arhefner/1802-Mini-SPI-DMA/README.md

# 1802-Mini-SPI-DMA
SPI Expansion Board for the 1802/Mini Computer
