arhefner/1802-Mini-SPI-DMA/1802-Mini-SPI-DMA.kicad_pcb

## KiCad design 1802-Mini-SPI-DMA.kicad_pcb (2022-12-16)

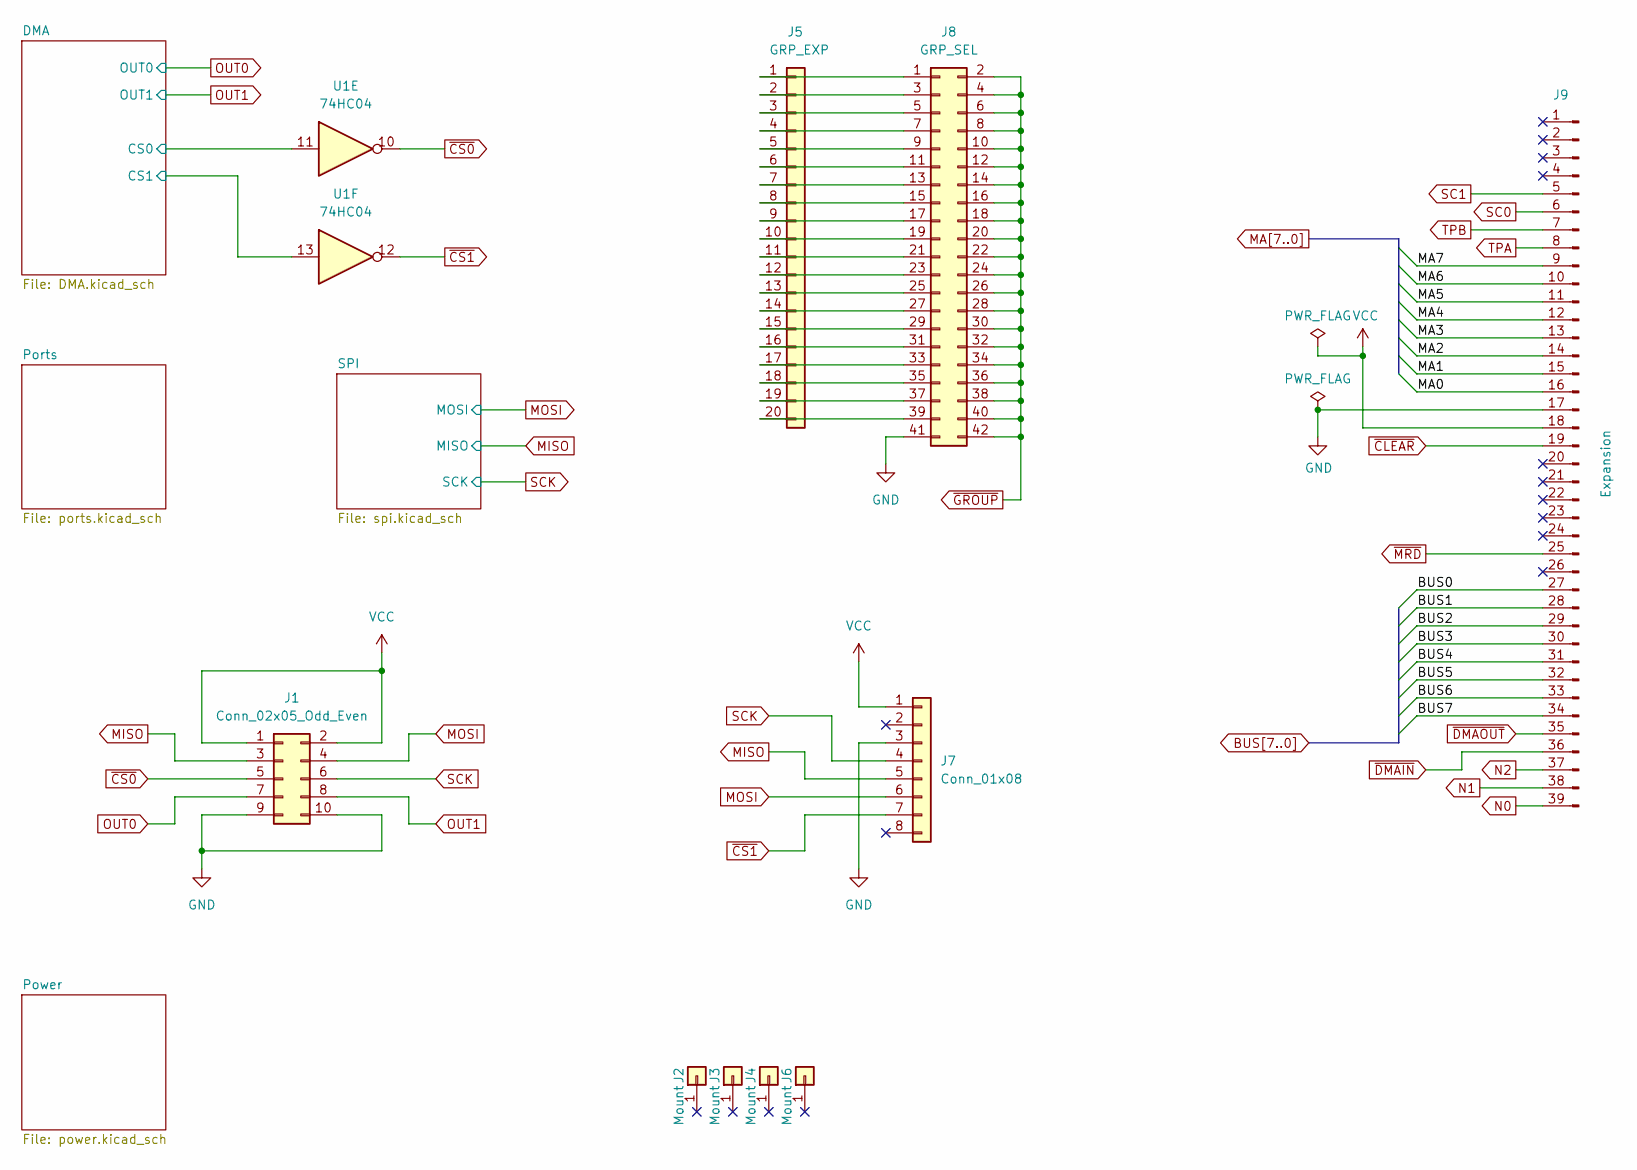
[picture p1: schematic 1802-Mini-SPI-DMA.kicad_sch]

Parts:
J1: Conn_02x05_Odd_Even; PinHeader_2x05_P2.54mm_Horizontal
J2, J3, J4, J6: Mount; 1pin
J5: GRP_EXP; PinHeader_1x20_P2.54mm_Vertical
J7: Conn_01x08; Adafruit_micro_sd_adapter
J8: GRP_SEL; PinHeader_2x21_P2.54mm_Vertical
J9: Expansion; Pin_Header_Straight_1x39_Pitch2.54mm
U1: 74HC04; DIP-14_W7.62mm_Socket

Connections:
/DMA/CS0: U1.11; also elsewhere on the board
/DMA/CS1: U1.13; also elsewhere on the board
BUS0: J9.27; also elsewhere on the board
BUS1: J9.28; also elsewhere on the board
BUS2: J9.29; also elsewhere on the board
BUS3: J9.30; also elsewhere on the board
BUS4: J9.31; also elsewhere on the board
BUS5: J9.32; also elsewhere on the board
BUS6: J9.33; also elsewhere on the board
BUS7: J9.34; also elsewhere on the board
GND: J1.9, J1.10, J7.3, J8.41, J9.17; also elsewhere on the board
MA0: J9.16
MA1: J9.15
MA2: J9.14
MA3: J9.13
MA4: J9.12
MA5: J9.11
MA6: J9.10
MA7: J9.9
MISO: J1.3, J7.5; also elsewhere on the board
MOSI: J1.4, J7.6; also elsewhere on the board
N0: J9.39; also elsewhere on the board
N1: J9.38; also elsewhere on the board
N2: J9.37; also elsewhere on the board
unnamed: J5.1, J8.1
unnamed: J5.2, J8.3
unnamed: J5.3, J8.5
unnamed: J5.4, J8.7
unnamed: J5.5, J8.9
unnamed: J5.6, J8.11
unnamed: J5.7, J8.13
unnamed: J5.8, J8.15
unnamed: J5.9, J8.17
unnamed: J5.10, J8.19
unnamed: J5.11, J8.21
unnamed: J5.12, J8.23
unnamed: J5.13, J8.25
unnamed: J5.14, J8.27
unnamed: J5.15, J8.29
unnamed: J5.16, J8.31
unnamed: J5.17, J8.33
unnamed: J5.18, J8.35
unnamed: J5.19, J8.37
unnamed: J5.20, J8.39
OUT0: J1.7; also elsewhere on the board
OUT1: J1.8; also elsewhere on the board
SC0: J9.6; also elsewhere on the board
SC1: J9.5; also elsewhere on the board
SCK: J1.6, J7.4; also elsewhere on the board
TPA: J9.8; also elsewhere on the board
TPB: J9.7; also elsewhere on the board
VCC: J1.1, J1.2, J7.1, J9.18; also elsewhere on the board
~CLEAR: J9.19; also elsewhere on the board
~CS0: J1.5, U1.10
~CS1: J7.7, U1.12
~DMAIN: J9.36; also elsewhere on the board
~DMAOUT: J9.35; also elsewhere on the board
~GROUP: J8.2, J8.4, J8.6, J8.8, J8.10, J8.12, J8.14, J8.16, J8.18, J8.20, J8.22, J8.24, J8.26, J8.28, J8.30, J8.32, J8.34, J8.36, J8.38, J8.40, J8.42; also elsewhere on the board
~MRD: J9.25; also elsewhere on the board

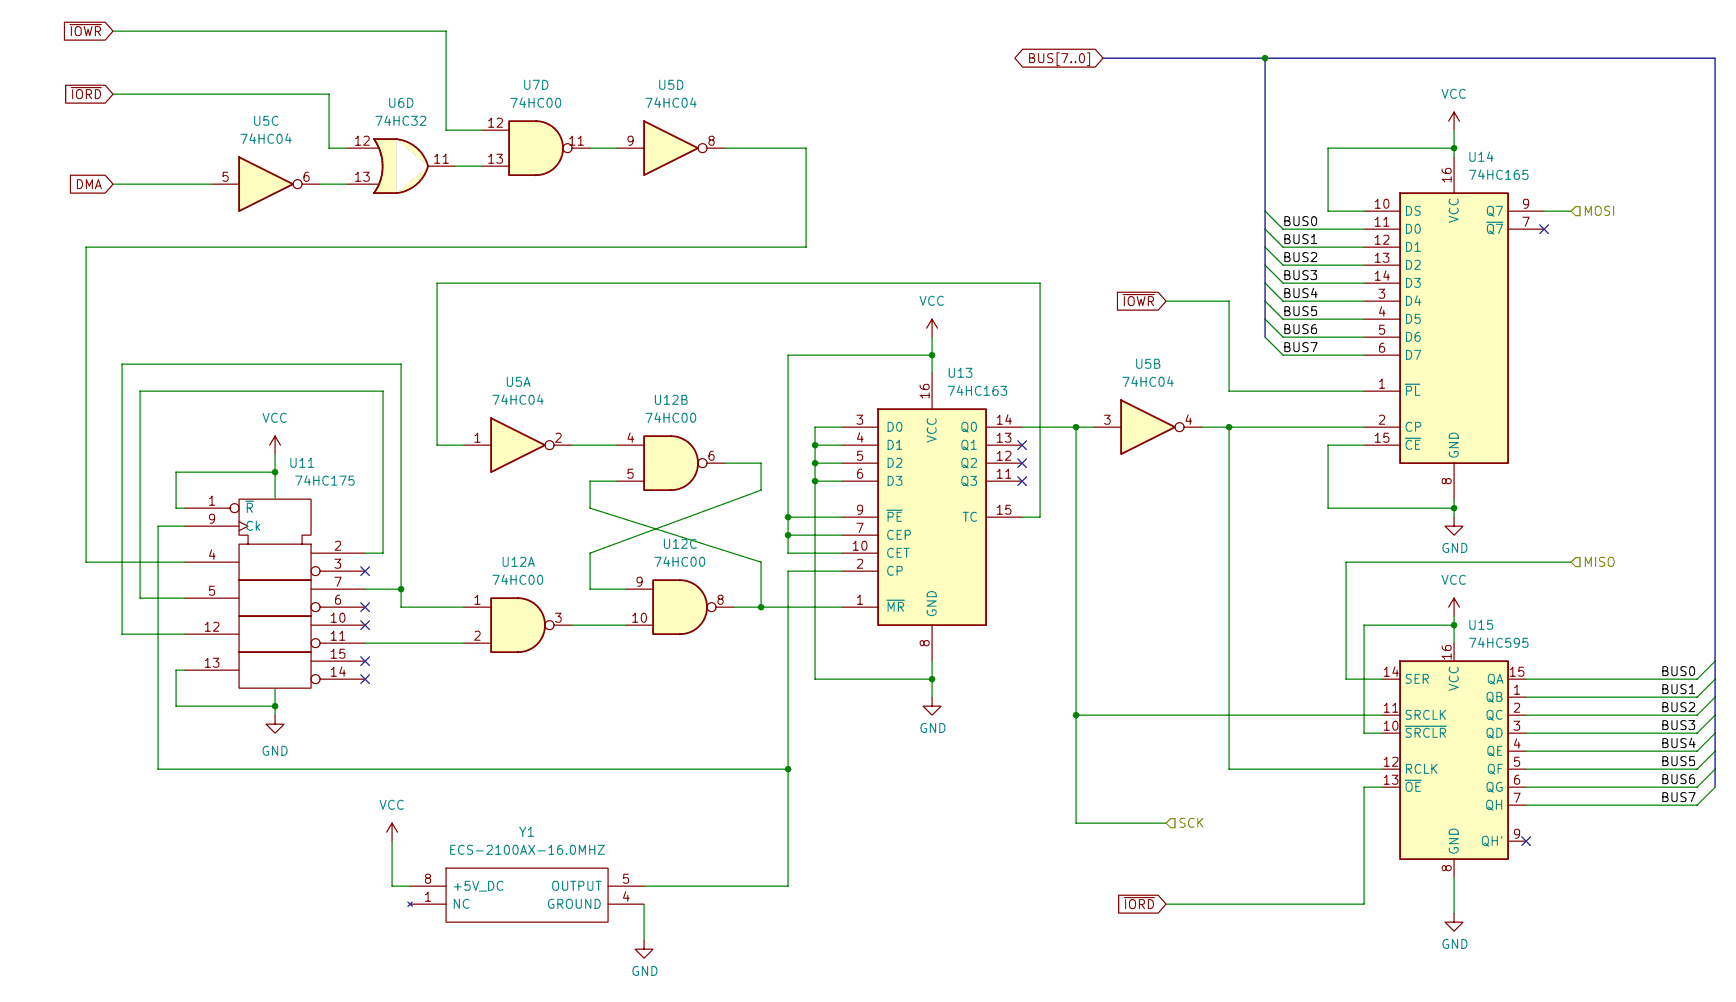
[picture p2: schematic spi.kicad_sch]

Parts:
U5: 74HC04; DIP-14_W7.62mm_Socket
U6: 74HC32; DIP-14_W7.62mm_Socket
U7, U12: 74HC00; DIP-14_W7.62mm_Socket
U11: 74HC175; DIP-16_W7.62mm_Socket
U13: 74HC163; DIP-16_W7.62mm_Socket
U14: 74HC165; DIP-16_W7.62mm_Socket
U15: 74HC595; DIP-16_W7.62mm_Socket
Y1: ECS-2100AX-16.0MHZ; ECS2100AX160MHZ; Mouser Part Number 520-TCH1600-X

Connections:
BUS0: U14.11 (D0), U15.15 (QA); also elsewhere on the board
BUS1: U14.12 (D1), U15.1 (QB); also elsewhere on the board
BUS2: U14.13 (D2), U15.2 (QC); also elsewhere on the board
BUS3: U14.14 (D3), U15.3 (QD); also elsewhere on the board
BUS4: U14.3 (D4), U15.4 (QE); also elsewhere on the board
BUS5: U14.4 (D5), U15.5 (QF); also elsewhere on the board
BUS6: U14.5 (D6), U15.6 (QG); also elsewhere on the board
BUS7: U14.6 (D7), U15.7 (QH); also elsewhere on the board
DMA: U5.5; also elsewhere on the board
GND: U11.8 (Vss), U11.13, U13.3 (D0), U13.4 (D1), U13.5 (D2), U13.6 (D3), U13.8 (GND), U14.8 (GND), U14.15 (~CE), U15.8 (GND), Y1.4 (GROUND); also elsewhere on the board
MISO: U15.14 (SER); also elsewhere on the board
MOSI: U14.9 (Q7); also elsewhere on the board
unnamed: U5.6, U6.13
unnamed: U5.9, U7.11
unnamed: U6.11, U7.13
unnamed: U11.2, U11.5
unnamed: U5.8, U11.4
unnamed: U11.9 (Ck), U13.2 (CP), Y1.5 (OUTPUT)
unnamed: U11.11, U12.2
unnamed: U11.7, U11.12, U12.1
unnamed: U5.2, U12.4
unnamed: U12.5, U12.8, U13.1 (~MR)
unnamed: U12.6, U12.9
unnamed: U12.3, U12.10
unnamed: U5.1, U13.15 (TC)
unnamed: U5.4, U14.2 (CP), U15.12 (RCLK)
SCK: U5.3, U13.14 (Q0), U15.11 (SRCLK); also elsewhere on the board
VCC: U11.1 (~R), U11.16 (Vdd), U13.7 (CEP), U13.9 (~PE), U13.10 (CET), U13.16 (VCC), U14.10 (DS), U14.16 (VCC), U15.10 (~SRCLR), U15.16 (VCC), Y1.8 (+5V_DC); also elsewhere on the board
~IORD: U6.12, U15.13 (~OE); also elsewhere on the board
~IOWR: U7.12, U14.1 (~PL); also elsewhere on the board

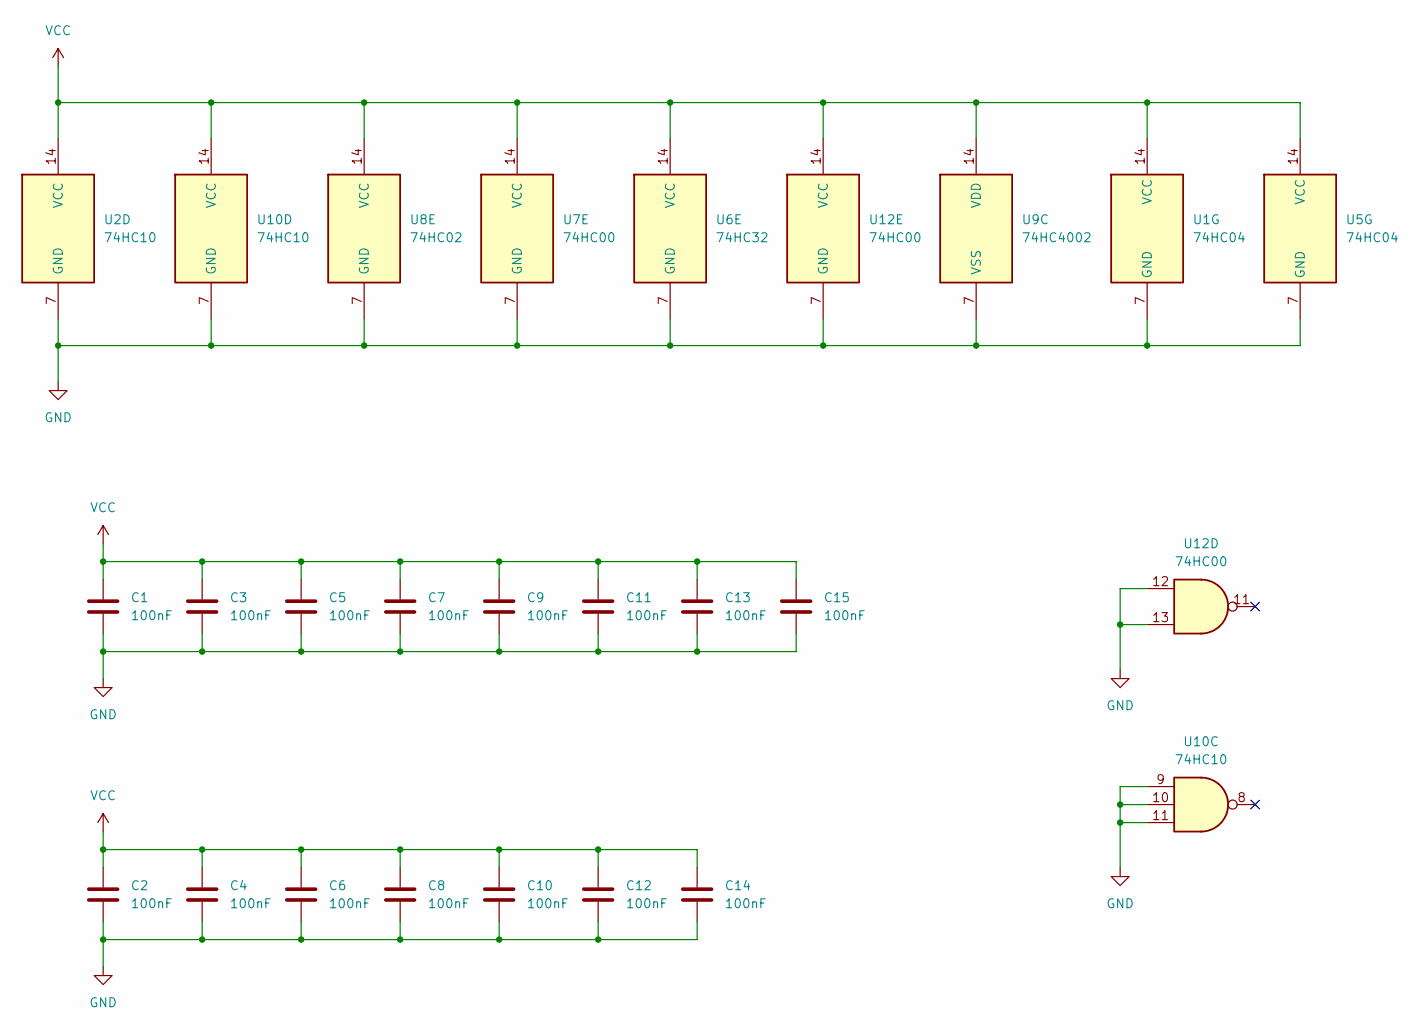
[picture p3: schematic power.kicad_sch]

Parts:
C1, C2, C3, C4, C5, C6, C7, C8, C9, C10, C11, C12, C13, C14, C15: 100nF; C_Disc_D4.7mm_W2.5mm_P5.00mm
U1, U5: 74HC04; DIP-14_W7.62mm_Socket
U2, U10: 74HC10; DIP-14_W7.62mm_Socket
U6: 74HC32; DIP-14_W7.62mm_Socket
U7, U12: 74HC00; DIP-14_W7.62mm_Socket
U8: 74HC02; DIP-14_W7.62mm_Socket
U9: 74HC4002; DIP-14_W7.62mm_Socket

Connections:
GND: C1.1, C2.1, C3.1, C4.1, C5.1, C6.1, C7.1, C8.1, C9.1, C10.1, C11.1, C12.1, C13.1, C14.1, C15.1, U1.7 (GND), U2.7 (GND), U5.7 (GND), U6.7 (GND), U7.7 (GND), U8.7 (GND), U9.7 (VSS), U10.7 (GND), U10.9, U10.10, U10.11, U12.7 (GND), U12.12, U12.13; also elsewhere on the board
VCC: C1.2, C2.2, C3.2, C4.2, C5.2, C6.2, C7.2, C8.2, C9.2, C10.2, C11.2, C12.2, C13.2, C14.2, C15.2, U1.14 (VCC), U2.14 (VCC), U5.14 (VCC), U6.14 (VCC), U7.14 (VCC), U8.14 (VCC), U9.14 (VDD), U10.14 (VCC), U12.14 (VCC); also elsewhere on the board

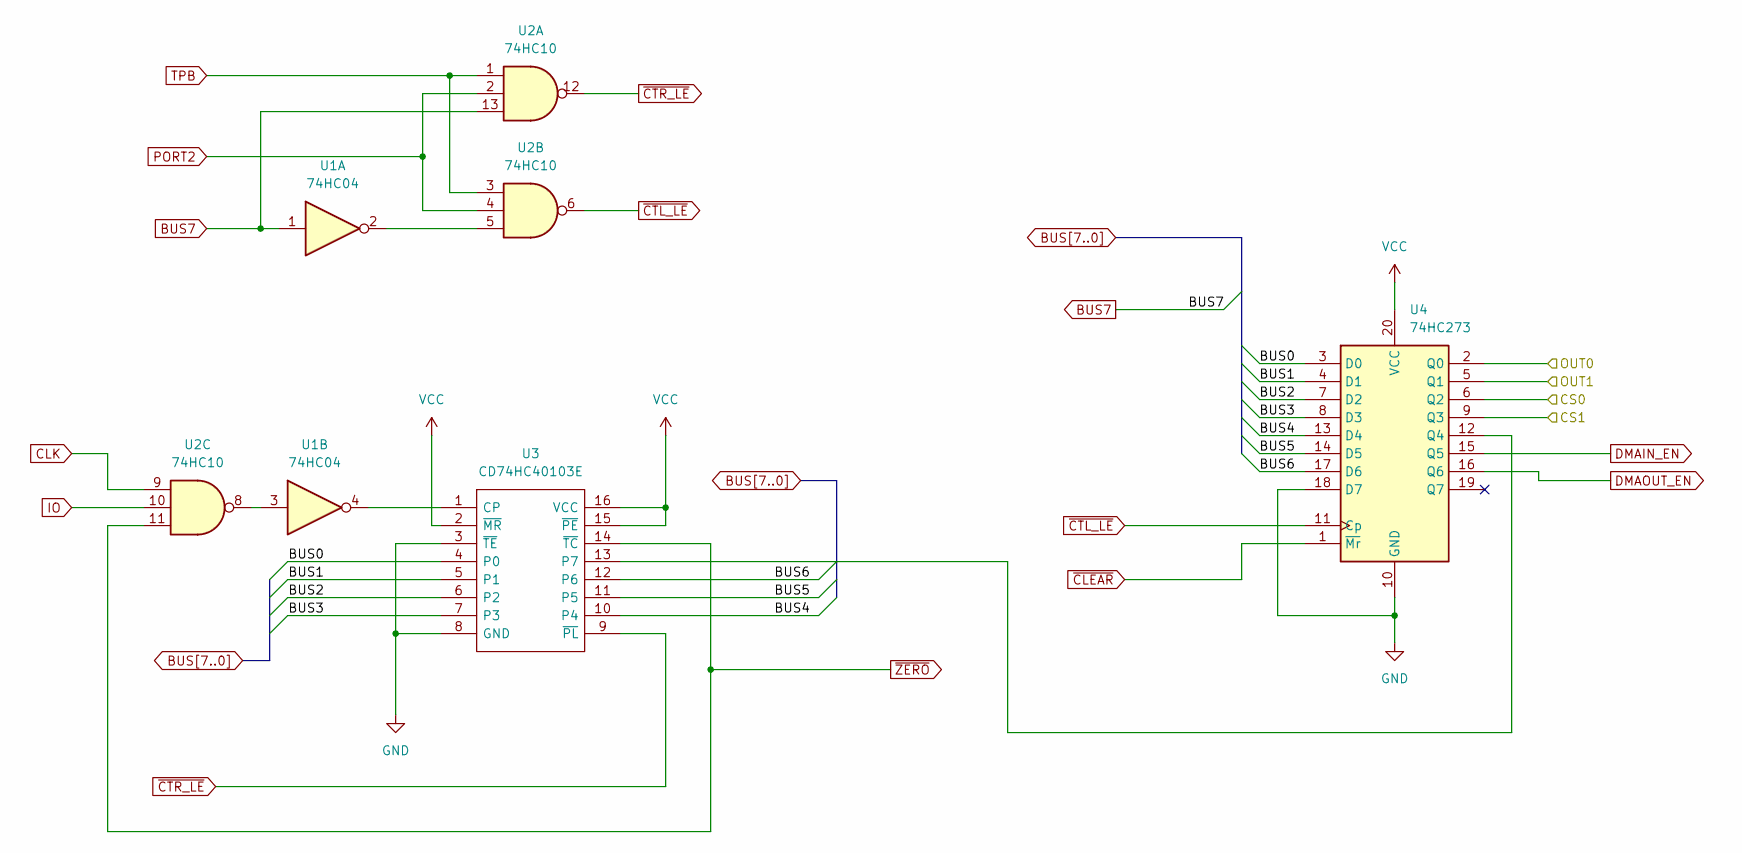
[picture p4: schematic DMA.kicad_sch]

Parts:
U1: 74HC04; DIP-14_W7.62mm_Socket
U2: 74HC10; DIP-14_W7.62mm_Socket
U3: CD74HC40103E; DIP-16_W7.62mm_Socket; Mouser Part Number 595-CD74HC40103E
U4: 74HC273; DIP-20_W7.62mm_Socket

Connections:
/DMA/CS0: U4.6 (Q2); also elsewhere on the board
/DMA/CS1: U4.9 (Q3); also elsewhere on the board
BUS0: U3.4 (P0), U4.3 (D0); also elsewhere on the board
BUS1: U3.5 (P1), U4.4 (D1); also elsewhere on the board
BUS2: U3.6 (P2), U4.7 (D2); also elsewhere on the board
BUS3: U3.7 (P3), U4.8 (D3); also elsewhere on the board
BUS4: U3.10 (P4), U4.13 (D4); also elsewhere on the board
BUS5: U3.11 (P5), U4.14 (D5); also elsewhere on the board
BUS6: U3.12 (P6), U4.17 (D6); also elsewhere on the board
BUS7: U1.1, U2.13; also elsewhere on the board
CLK: U2.9; also elsewhere on the board
DMAIN_EN: U4.15 (Q5); also elsewhere on the board
DMAOUT_EN: U4.16 (Q6); also elsewhere on the board
GND: U3.3 (~TE), U3.8 (GND), U4.10 (GND), U4.18 (D7); also elsewhere on the board
IO: U2.10; also elsewhere on the board
unnamed: U1.2, U2.5
unnamed: U1.3, U2.8
unnamed: U1.4, U3.1 (CP)
unnamed: U3.13 (P7), U4.12 (Q4)
OUT0: U4.2 (Q0); also elsewhere on the board
OUT1: U4.5 (Q1); also elsewhere on the board
PORT2: U2.2, U2.4; also elsewhere on the board
TPB: U2.1, U2.3; also elsewhere on the board
VCC: U3.2 (~MR), U3.15 (~PE), U3.16 (VCC), U4.20 (VCC); also elsewhere on the board
~CLEAR: U4.1 (~Mr); also elsewhere on the board
~CTL_LE: U2.6, U4.11 (Cp)
~CTR_LE: U2.12, U3.9 (~PL)
~ZERO: U2.11, U3.14 (~TC); also elsewhere on the board

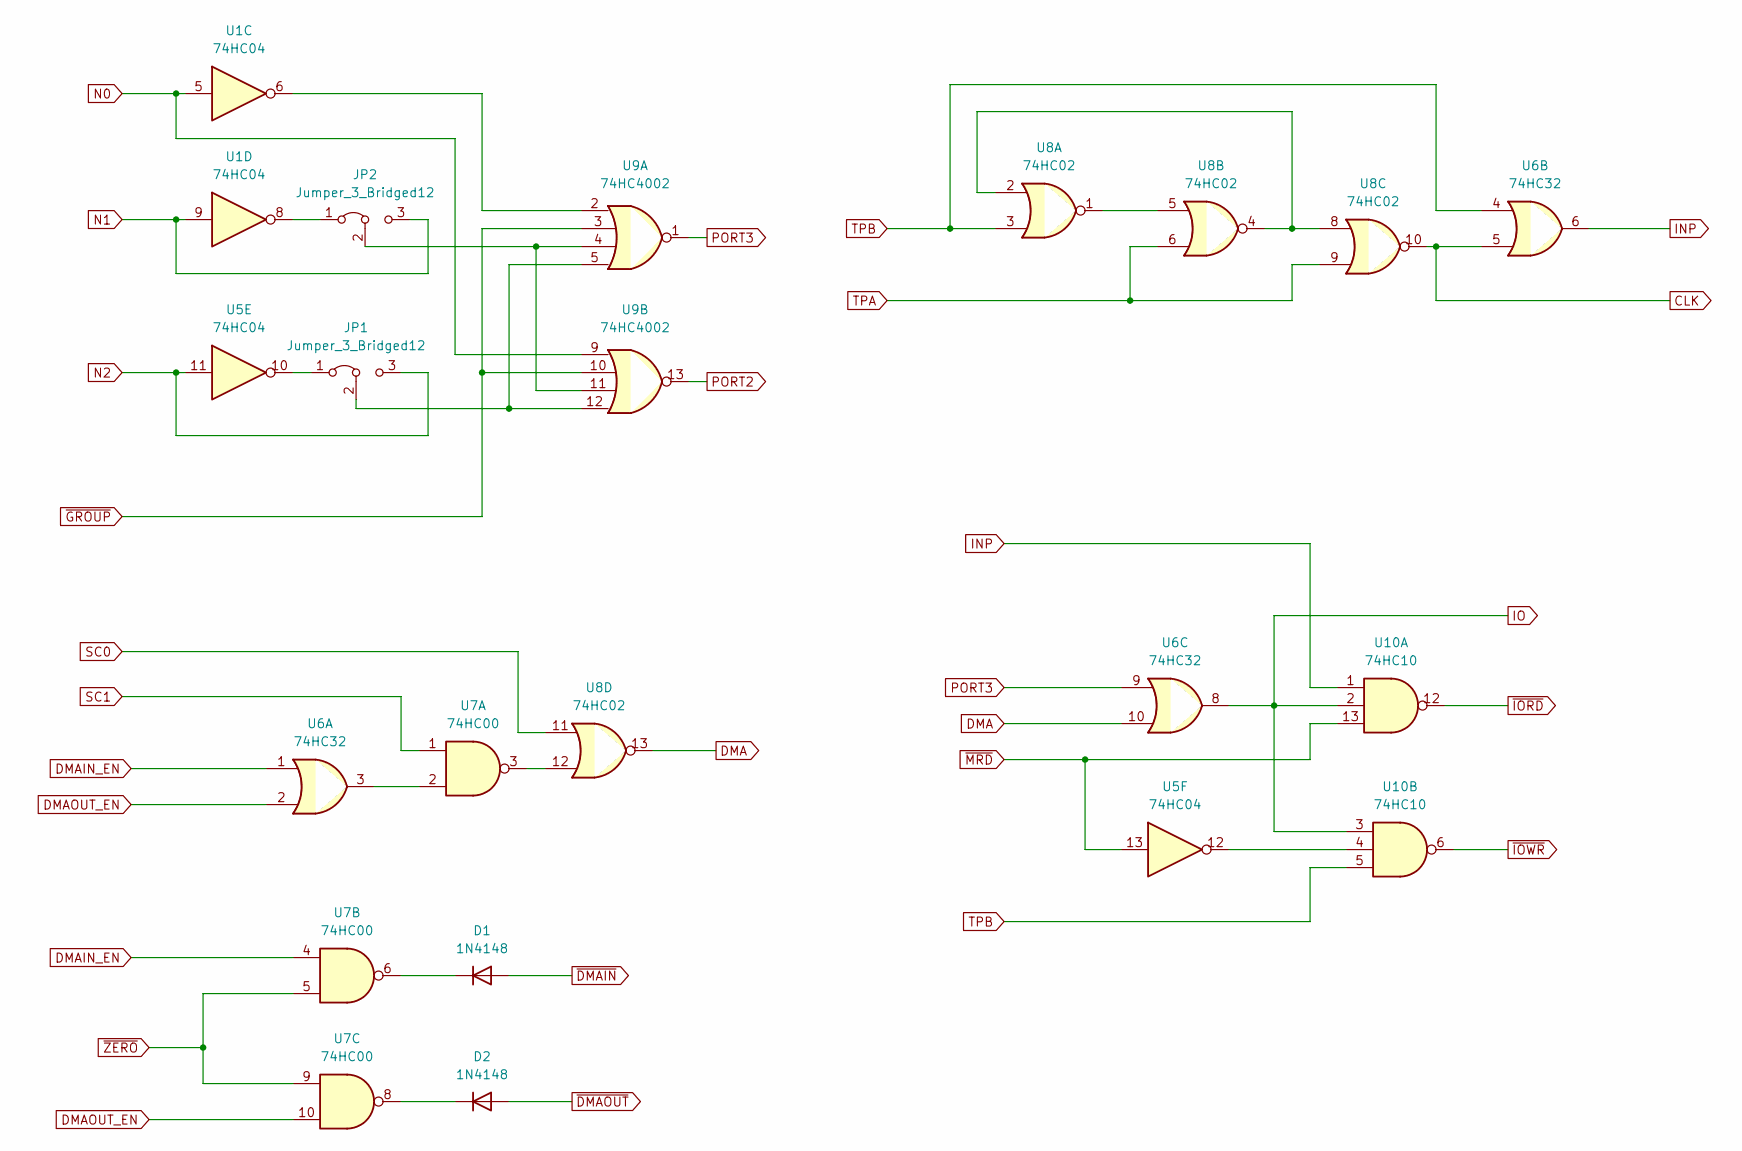
[picture p5: schematic ports.kicad_sch]

Parts:
D1, D2: 1N4148; D_DO-35_SOD27_P7.62mm_Horizontal
JP1, JP2: Jumper_3_Bridged12; PinHeader_1x03_P2.54mm_Vertical
U1, U5: 74HC04; DIP-14_W7.62mm_Socket
U6: 74HC32; DIP-14_W7.62mm_Socket
U7: 74HC00; DIP-14_W7.62mm_Socket
U8: 74HC02; DIP-14_W7.62mm_Socket
U9: 74HC4002; DIP-14_W7.62mm_Socket
U10: 74HC10; DIP-14_W7.62mm_Socket

Connections:
CLK: U6.5, U8.10; also elsewhere on the board
DMA: U6.10, U8.13; also elsewhere on the board
DMAIN_EN: U6.1, U7.4; also elsewhere on the board
DMAOUT_EN: U6.2, U7.10; also elsewhere on the board
INP: U6.6, U10.1
IO: U6.8, U10.2, U10.3; also elsewhere on the board
N0: U1.5, U9.9; also elsewhere on the board
N1: JP2.3 (B), U1.9; also elsewhere on the board
N2: JP1.3 (B), U5.11; also elsewhere on the board
unnamed: D1.1 (K), U7.6
unnamed: D2.1 (K), U7.8
unnamed: JP1.1 (A), U5.10
unnamed: JP1.2 (C), U9.5, U9.12
unnamed: JP2.1 (A), U1.8
unnamed: JP2.2 (C), U9.4, U9.11
unnamed: U1.6, U9.2
unnamed: U6.3, U7.2
unnamed: U7.3, U8.12
unnamed: U8.1, U8.5
unnamed: U8.2, U8.4, U8.8
unnamed: U5.12, U10.4
PORT2: U9.13; also elsewhere on the board
PORT3: U6.9, U9.1
SC0: U8.11; also elsewhere on the board
SC1: U7.1; also elsewhere on the board
TPA: U8.6, U8.9; also elsewhere on the board
TPB: U6.4, U8.3, U10.5; also elsewhere on the board
~DMAIN: D1.2 (A); also elsewhere on the board
~DMAOUT: D2.2 (A); also elsewhere on the board
~GROUP: U9.3, U9.10; also elsewhere on the board
~IORD: U10.12; also elsewhere on the board
~IOWR: U10.6; also elsewhere on the board
~MRD: U5.13, U10.13; also elsewhere on the board
~ZERO: U7.5, U7.9; also elsewhere on the board

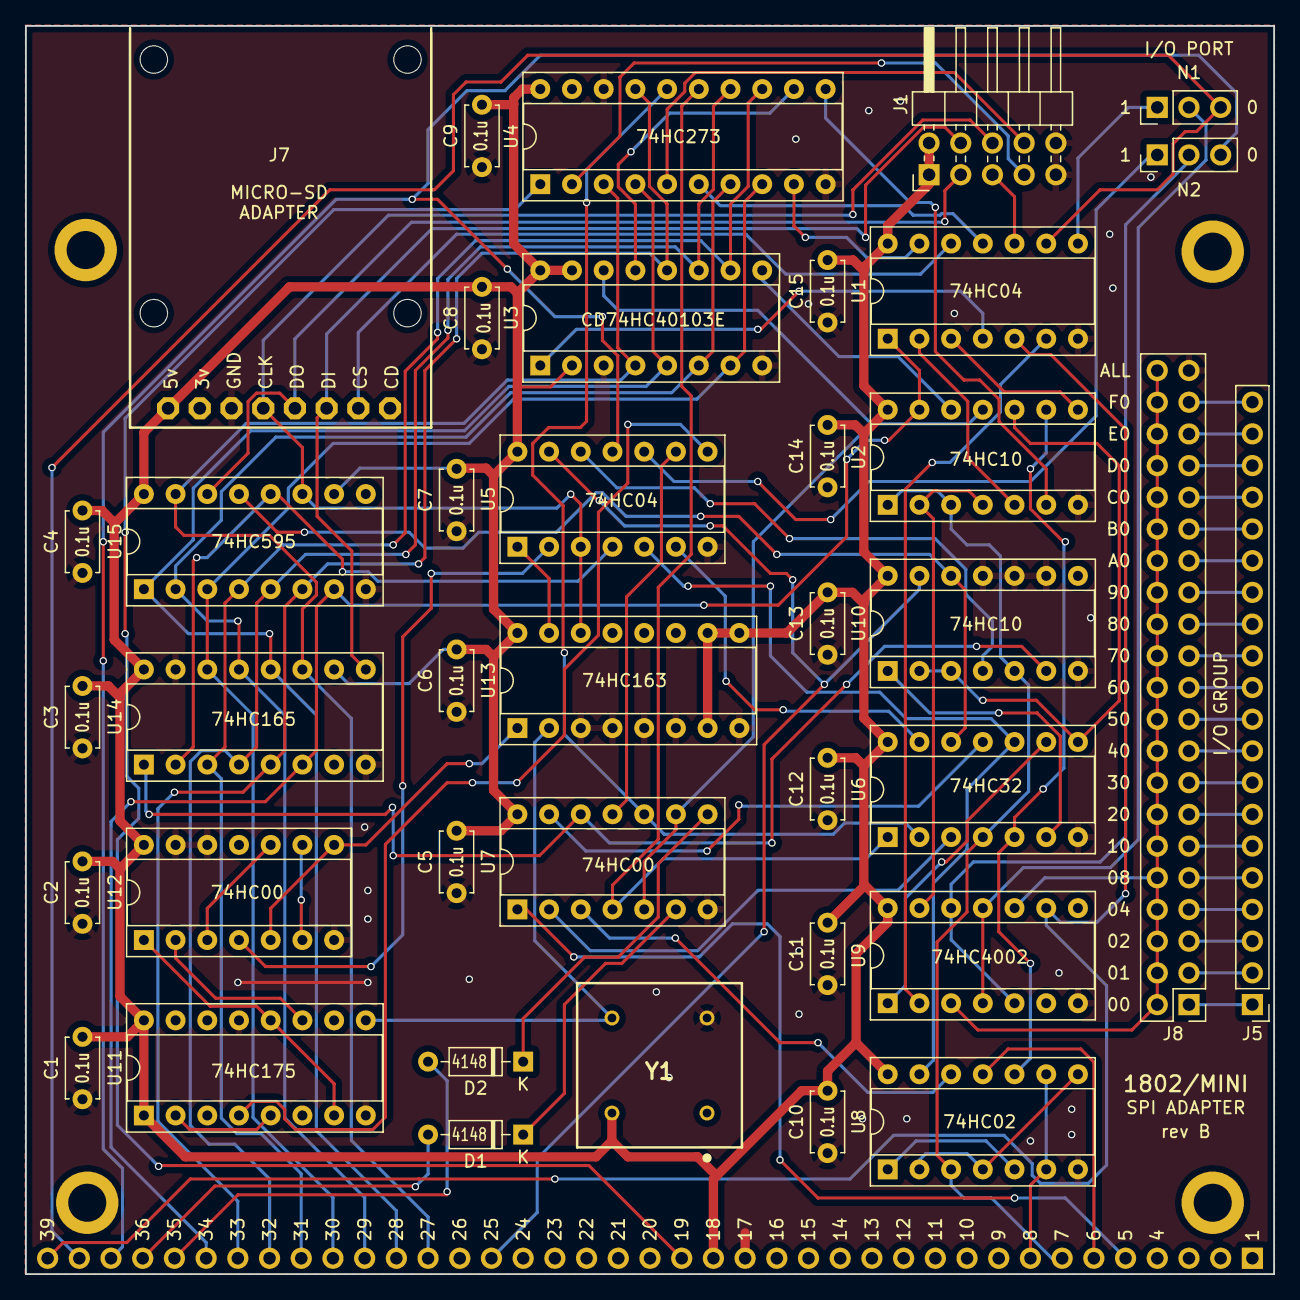
[picture p6: board 1802-Mini-SPI-DMA.kicad_pcb from above]

Board: 2 copper layers, 100.0 x 100.0 mm, 44 parts (0 on the bottom side), 94 nets.
