arhefner/1802-Mini-SPI-DMA/(commit log)

2022-10-27 Initial commit of project.
    [1802-Mini-SPI-DMA.kicad_pcb, 1802-Mini-SPI-DMA.kicad_sch, DMA.kicad_sch, ports.kicad_sch, power.kicad_sch, spi.kicad_sch]
2022-11-29 Add BOM and errata
    [1802-Mini-SPI-DMA-BOM.xlsx]
2022-12-16 Update silk screen.
    [1802-Mini-SPI-DMA.kicad_pcb]
